Frost33/Control-ON-OFF-para-horno-con-temperatura-maxima-70-C-/README.md

# Control-ON-OFF-para-horno-con-temperatura-maxima-70-C-
En este repositorio se especifica el diseño de un controlador ON-OFF para una planta termica de primer Orden
