Frost33/Control-ON-OFF-para-horno-con-temperatura-maxima-70-C-/DiseñoDisparador.pdf

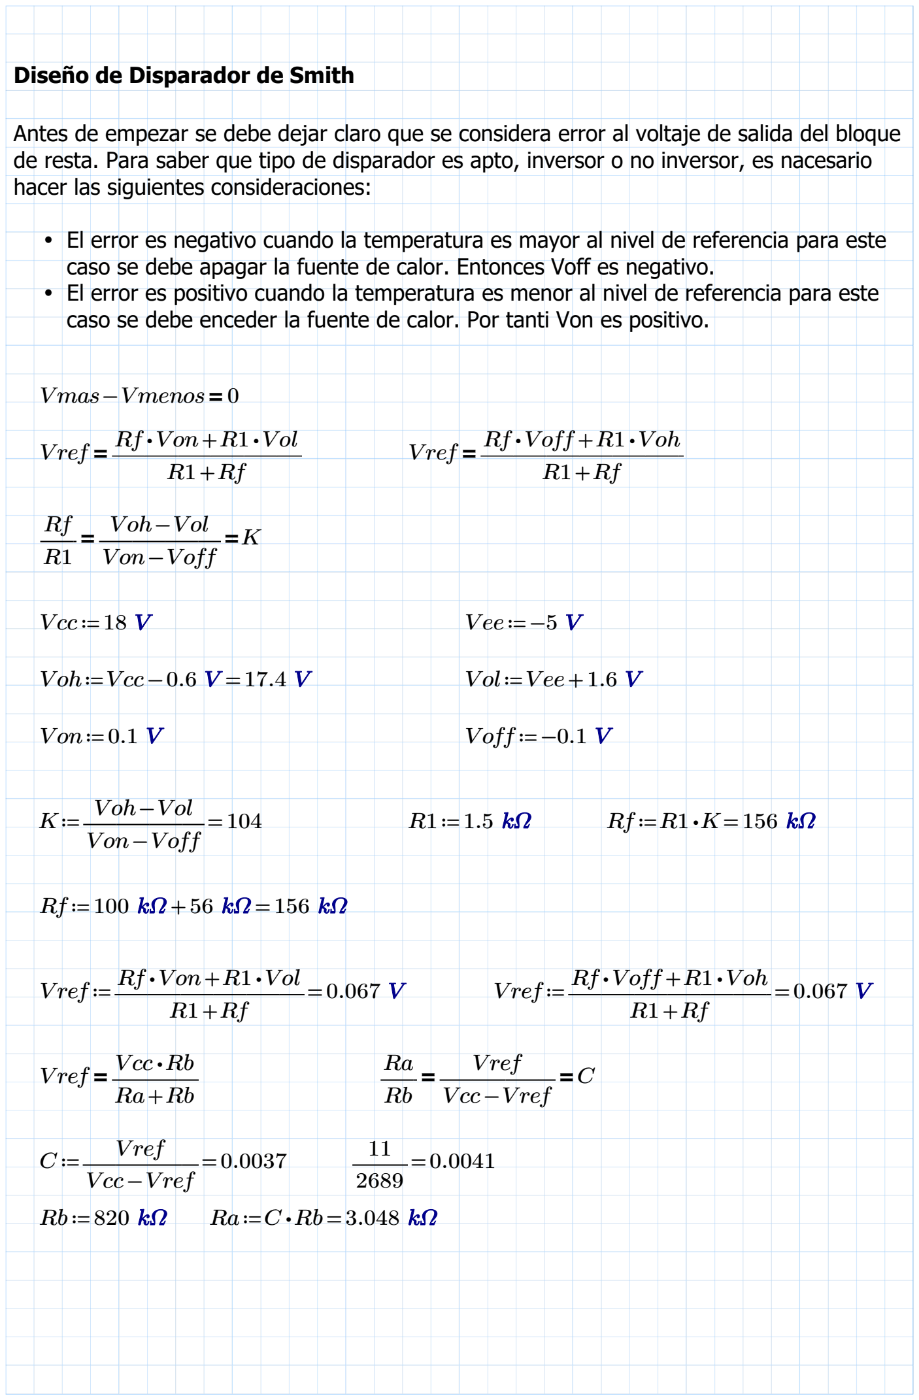
[picture p1: page 1]

Diseño de Disparador de Smith

Antes de empezar se debe dejar claro que se considera error al voltaje de salida del bloque de resta. Para saber que tipo de disparador es apto, inversor o no inversor, es nacesario hacer las siguientes consideraciones:

El error es negativo cuando la temperatura es mayor al nivel de referencia para este caso se debe apagar la fuente de calor. Entonces Voff es negativo.
El error es positivo cuando la temperatura es menor al nivel de referencia para este caso se debe enceder la fuente de calor. Por tanti Von es positivo.

Vmas−Vmenos＝0
Vref＝―Rf―⋅Von―+―R1―⋅Vol ― R1+Rf

Vref＝―Rf―⋅Voff ―+―R1―⋅Voh ―― R1+Rf

――＝ | ＝

Rf

R1 ―Voh―−―Vol― Von−Voff
K
Vcc≔18 V | Vee≔−5 V
Voh≔Vcc−0.6 V =17.4 V | Vol≔Vee+1.6 V
Von≔0.1 V | Voff≔−0.1 V

K≔――――=

Voh−Vol
Von−Voff
104 | R1≔1.5 kΩ | Rf≔R1 ⋅K=156 kΩ

Rf≔100 kΩ +56 kΩ =156 kΩ

Vref≔――――――=

Rf ⋅Von+R1 ⋅Vol
R1+Rf
0.067 V | Vref≔―――――――=
| | Rf ⋅Voff+R1 ⋅Voh R1+Rf 0.067 V
Vref＝―Vcc―⋅Rb― Ra+Rb | ――＝ | ＝
| Ra Rb ――Vref―― Vcc−Vref | C

C≔――――=

Vref
Vcc−Vref

0.0037 ――=

| 11
| 2689
| 0.0041
Rb≔820 kΩ | Ra≔C⋅Rb=3.048 kΩ

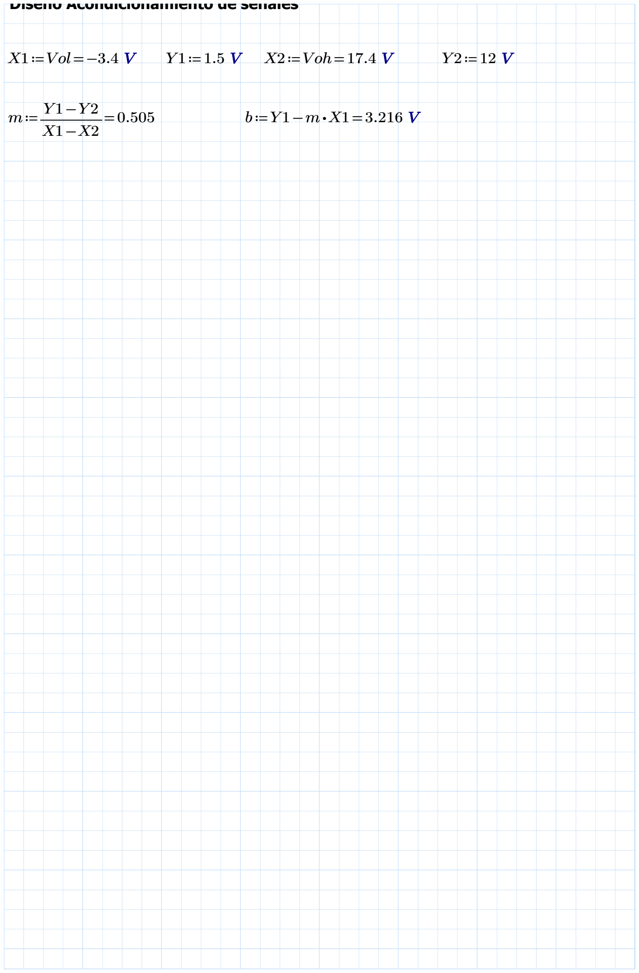
[picture p2: page 2]

Diseño Acondicionamiento de señales

X1≔Vol=−3.4 V | Y1≔1.5 V X2≔Voh=17.4 V | Y2≔12 V

m≔―――=

Y1−Y2
X1−X2

0.505 b≔Y1−m⋅X1=3.216 V
