Frost33/Control-ON-OFF-para-horno-con-temperatura-maxima-70-C-/Practica3-ControlON-OFF.pdf

# Practica No.3 Caracterización y Control ON/OFF de

un Sistema Térmico.

Nicolás David Pastran Zamora Ingeniería Elecrtrónica
Universidad Distrital Francisco José de Caldas
Bogotá, Colombia
ndpastranz@correo.udistrital.edu

David Sebastián Rodriguez Jímenez Ingeniería Elecrtrónica
Universidad Distrital Francisco José de Caldas
Bogotá, Colombia
dsrodriguezj@correo.udistrital.edu.co

Daniel E. A. Hernández Carreño Ingeniería Elecrtrónica
Universidad Distrital Francisco José de Caldas
Bogotá, Colombia
deahernandezc@correo.udistrital.edu.co

Abstract—The characterization of a thermal system is performed using the step response method and an On-Off temperature control is implemented considering the stages of census, power and conditioning of the error signal.

Resumen—Se realiza la caracterización de un sistema térmico usando el método de respuesta al escalón y se implementa un control de temperatura On-Off considerando las etapas de censado, potencia y acondicionamiento de la señal de error.

Palabras clave— Caracterización, Control, Error, Potencia, Señal, Temperatura.

I. INTRODUCCIÓN
En esta práctica de laboratorio se propone realizar el montaje, caracterización e implementación de un sistema térmico con un control de temperatura ON/OFF.
Para la construcción la planta térmica se precisa usar un bombillo de faro para motocicleta de 12 V y 20 W como fuente térmica, un censor de temperatura LM35 para el medir la temperatura interna de la planta térmica, envases de icopor de 24 oz como aislamiento y cuerpo de la planta térmica; usando dos envases de icopor, en el interior de los cuales se coloca el bobillo y el sensor de temperatura fijos en su lugar con macilla epoxi, dejando las conexiones eléctricas de cada uno accesibles desde el exterior de la planta.
El sistema control ON/OFF consiste de una etapa acondicionamiento de la señal de voltaje del LM35 y un comparador con el valor de referencia, empleando los amplificadores operacionales TL084CN y LM353.
Para controlar el encendido y apagado del bobillo se precisa de una etapa de potencia conformada por un seguidor de voltaje y un transistor MOSFET IRFP250N.
La caracterización de la planta térmica se realiza en lazo abierto con el funcionamiento de las etapas de potencia y de comparación, teniendo un valor de referencia fijo entre 0 y 12 V.

II. DESCRIPCIÓN DEL SISTEMA
Para este laboratorio se implementa un sistema de lazo cerrado como el mostrado en la Fig. 1.
Donde la señal de entrada es un voltaje de referencia el cual representa la temperatura deseada y la salida es la temperatura que tiene la planta.

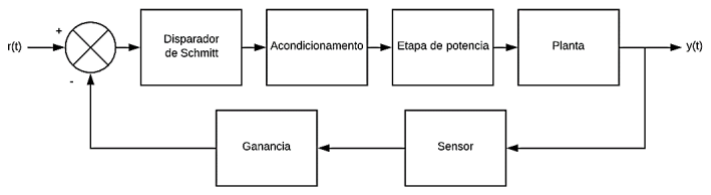
[picture p3: figure]

Fig. 1. Diagrama de bloques del sisetame de lazo cerrado.

Para el diseño del primer bloque (el disparador de Schmitt), se utilizan las ecuaciones de diseño de un disparador de Schmitt no inversor como el de la Fig. 2, las cuales son:

Rf
R1

=

VOH − VOL

VON −VOFF

VREF =

VON RF + VOL R1
R1 + RF | , | VREF =

VOFF RF + VOH R1
R1 + RF

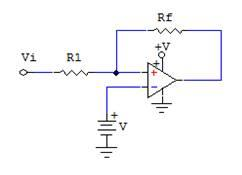
[picture p4: figure]

Fig. 2. Topologia de disparador de Schmitt no inversor.

Para este diseño se decide usar una fuente Vcc

+ de 18V para
sobredimensionar perdidas por la etapa de potencia y Vcc

− de
-5V para sobredimensionar la mínima entrada negativa.
Con anterioridad se caracterizo VOH y VOL del lm que se utilizara para tener más precisión, los resultados fueron:

VOH = Vcc

+ − 0.6 = 17.4V, VOL = Vcc

− + 1.6 = −3.4V

Para este diseño se sabe que VON = 0.1 y VOFF = −0.1 , con estos datos se procede a hallar los valores de las resistencias:

RF
R1

=

17.4 + 3.4
0.1 + 0.1

= 104, RF = 104 R1

VREF =

0.1 104 + (−3.4) 1
1 + 104 =

1
15

VREF =

(−0.1)104 + 17.4 1
1 + 104 =

1
15

El voltaje VREF se hace haciendo un divisor resistivo con Vcc

+ ya que la impedancia de entrada del amplificador operacional es muy alta, por lo la relación resistiva es la siguiente:
1
15 =

18V Ra
Ra + Rb ,

Rb
Ra = 15 × 18 − 1 = 269

Rb = 269 Ra

Dadas estas condiciones de diseño se buscan las resistencias adecuadas que cumplan esas características, para este caso se encontró que:

Si R1 = 1.5KΩ entonces RF = 156KΩ = 100KΩ + 56KΩ

Si Ra = 820KΩ entonces Rb = 3.048KΩ ≈ 3KΩ

El bloque de acondicionamiento es necesario dado que la salida del disparador será VOH = 17.4 y VOL = −3.4 pero la entrada de la etapa de potencia idealmente debería ir máximo hasta 12V ya que es el valor nominal del bombillo utilizado y
mínimo 1.5V ya que este tendrá como Vcc | − = 0V por lo quela
entrada mínima debe ser aproximadamente VIL = Vcc

− +1.5 =
1.5V ademas para este voltaje el bombillo aún no ha encendido así que no es necesario que el voltaje de entrada del seguidor sea 0, asimismo otra ventaja es que el transistor utilizado para la etapa de potencia tiene que soportar un voltaje equivalente a la siguiente ecuación:

Vtransistor = Vcc

+ −Vbombillo

Por lo tanto, si el voltaje mínimo del bombillo es mayor a cero, el voltaje que debe soportar el transistor no será siempre menor al que entrega la fuente de polarización haciendo menos probable que este se queme.
Para el diseño de esta etapa se busca que cuando el voltaje de entrada sea -3.4V el voltaje de salida sea 1.5V y cuando el voltaje de entrada sea 17.4V el voltaje de salida sea 12V, los valores intermedios deben actuar de manera lineal, por lo que se halla la ecuación que describe la función lineal dados dos puntos:

m =

y2 − y1
x2 − x1

=

12 −1.5 17.4 + 3.4 | =
| 105
| 208

Hallada la pendiente se procede a hallar el punto de corte con el eje y (llamado b).

12 =

105
208

× 17.4 +b

b = 12 −

105

208 × 17.4 = | 669
| 208

De este modo la función deseada es:

y =

105
208 Vi +

669
208 , y =

105
208 Vi +

223
1248 18V

Se usa un multientradas para generar esa función de transferencia, por lo que se utilizan las ecuaciones del diseño de multientradas:
A

+ = A

− +1, | A + =
| 105 208 + | 223 1248 =
| | 853
| | 1248

Como A

+ < 1 entonces A

− = 0 y falta agregar una
ganancia positiva más para completar 1.

853
1248 +Aa
+ = 1, | Aa
| + = 1 − | 853 1248 =
| | 395
| | 1248

Por lo que se evidencia que no es necesario hacer un multi entradas, sino que se puede hacer un acondicionamiento resistivo con tres resistencias y luego el seguidor de la etapa de potencia, donde Ra ira conectada a la salida del disparador, Rb a Vcc

+y
Rc a tierra.
Para facilitar su cálculo se sigue tratando como un multi entradas con la siguiente ecuación:

y =

105
208 Vi +
| 223 1248 18V + | 395 1248 0V

De donde la relación de resistencias será:

Rf Ra =

105

208 | Rf Rb =
| 223
| 1248 | Rf Rc =
| | 395
| | 1248

Con estos datos se pueden hallar las relaciones entre resistencias sin tener en cuenta Rf, dividiendo entre sí, de manera que:

Ra
Rc =

395
1248 ÷
105 208 = | 79 126 , Rb Rc = | 395
| | 1248 ÷
| | 223 1248 =

395
223

Por lo que tenemos dos grados de libertad, de este modo buscamos valores adecuados para aproximarnos lo más posible a estas relaciones, para nuestro caso se escogieron:

Ra = 15KΩ | Rb = 45KΩ | Rc = 22KΩ

Para la etapa de potencia se diseña un seguidor de voltaje de potencias con un amplificador operacional y un transistor MOSFET de potencia, como el de la Fig. 3. De forma que el voltaje Vref a la entrada del amplificador operacional excitará la compuerta del MOSFET y el voltaje sobre el bobillo será próximo al voltaje Vref

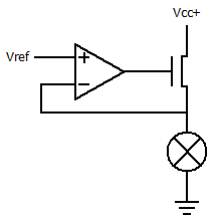
[picture p5: figure]

Fig. 3. Etapa de potencia. Seguidor de voltaje.

Para proporcionar la corriente necesaria para encender el bombillo en el rango de 0 V a 12 V, se sobre dimensiona el diseño y se escoge trabajar con un el transistor de potencia IRFP250N, que soporta una corriente iD de 30 A y una disipación de potencia de 214 W.
Dada la realimentación negativa del operacional V

+ = V

−
el voltaje sobre el bobillo (el cual se tratará como una resistencia R), será gmvgsR, por lo tanto

V

+ = V

− = gmvgsR, vgs =

V

−
gmR

v0 = vgs + V

−, v0 = V

− (1 +

1
gmR

)

Según [3], el valor de gm para el IRFP250N es de 17 S y el valor de resistencia del bombillo a 12 V es de 6.1 Ω. El límite de operación se encontrará cuando v0
se acerque al valor de la
fuente de polarización, es decir, cuando Vref sea 12 V

v0,max = 12 (1+

1
17 ∗ 6.1

) = 12.12 V

Para el caso del TL084CN con polarización +Vcc = 18 V y −Vcc = 0 V, el valor de voltaje v0,max y v0,min que se podrá tener a la salida antes que se sature el amplificador operacional es de 17 V y 1 V respectivamente [4]. Por lo tanto, el seguidor de voltaje de potencia se comportará de manera lineal en el rango de 1.5 V a 12 V.
Para la etapa de censado se emplea un sensor de temperatura de LM35, para este se tiene un rango de temperatura operación de temperatura de -55 °C a 150°C, con una precisión de 1 °C a temperatura ambiente y de 1.5°C a la temperatura máxima. El LM35 puede ser polarizado como máximo con una fuente de 30 V y requiere un voltaje mínimo de polarización de 3.5 V para realizar medidas a 75 °C. [2]
Para polarizar el amplificador operacional se usa un rectificador de voltaje a 5.1 V, como el de la Fig. 4, para asegurar que el sensor realice mediaciones estables y certeras ene l rango de 25°C a 75°C. También se toma la sugerencia del fabricante para usar el sensor con una sola fuente junto con un amortiguador RC, para disminuir el ruido eléctrico de alta frecuencia en la salida del sensor. [2]

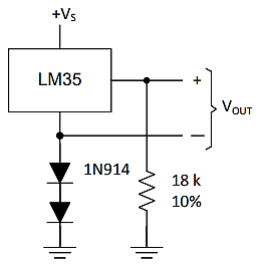
[picture p6: figure]

Fig. 4. Sensor LM35 polarizado con una fuente. [2]

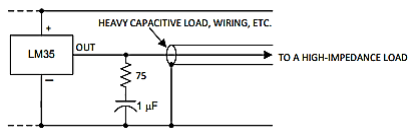
[picture p7: figure]

Fig. 5. Sensor LM35 con amortiguador RC. [2]

La respuesta del sensor al aire quieto tarda 4 minutos en llegar al 100% del valor final, este aspecto que se ve incluido en la caracterización de la planta más adelante. [2]
Posterior a la etapa de censado, por datos del diseño se debe adecuar la salida del sensor para que el voltaje que entre al restador sea de 100 mV
C°

dado que el sensor utilizado tiene como salida 10 mV
C°

es evidente que es suficiente con amplificar la salida 10 veces, para esto se utilizara la topología del amplificador no inversor como el mostrado en la Fig. 3 cuya ecuación que describe su comportamiento es:

Vo = 1+

Rf
R1

= 10

Rf
R1

= 9

Para cumplir esta condición se escogen los siguientes valores resistivos:
Rf = 9KΩ = 18KΩ//18KΩ
R1 = 1KΩ

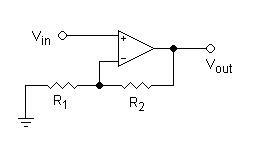
[picture p8: figure]

Fig. 6. Topologia de amplificador no inversor.

Por último, se procede al diseño del restador como el visto en la Fig. 4.
Ajustando la ecuación para que cumpla que A

+ = A

− + 1 se
tiene que:

y = Va − Vb + 1

Donde Va es la entrada del sistema y Vb es la salida del sensor amplificada. Con estos datos se procede a hallar la relación de resistencias adecuadas para satisfacer la ecuación:

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
Por lo que para satisfacer la ecuación todas las resistencias deben ser iguales.

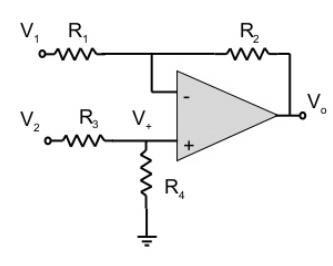
[picture p9: figure]

Fig. 7. Topologia de multientradas (restador).

III. IDENTIFICACIÓN DEL SISTEMA
Para identificar el sistema descrito en la Fig. 1 de forma analítica, se planteará el modelamiento del sistema dinámico por medio de variables de estado, una vez obtenidas estas encontrar la ecuación característica del sistema, donde la entrada será el voltaje de la resistencia y la salida la temperatura del recipiente.

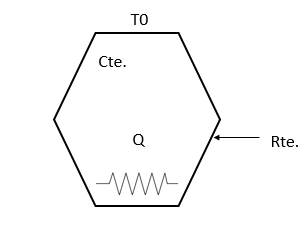
[picture p10: figure]

Fig. 8. Figura Representativa para el sistema.

Modelamiento Teórico

Para modelar el sistema se deben identificar los elementos que componen al mismo, estos son la resistencia al flujo de calor en el resipiente, caracteristica por las dimenciones del resipiente y el material del mismo; el otro elemento del sistema es la capacitancia inherente de los cuerpos al almacenar calor en forma de energia interna, esta propiedad existe debido al fluido que almacenado en el resipiente y de su volumen. Antes de empezar el modelamiento se realizara el calculo de estos elementos para el sistema particular. Para el elemento disipador de energia:

Rℎ =

A
l ∗ ρ
Donde:

Rℎ, Es la Resistencia terminal
A, Es el Área del recipiente la base, la tapa y las laterales l , Es el espesor del recipiente
ρ, Es la conductividad del material en este caso poliestireno expandido

Rl =

2 ∗ π ∗ 6cm ∗ 24cm
2m ∗ m ∗ 0.041 W
K ∗ m

= 1103.38

K
W

Rb =

π ∗ (6cm)

2
2m ∗ m ∗ 0.041 W
K ∗ m

= 137.92

K
W

Rt =

π ∗ (6cm)

2
2m ∗ m ∗ 0.041 W
K ∗ m

= 137.92

K
W

Rℎ = Rs||Rb||Rt = 64.90

K
W

Para el elemento que almacena energia potencial:

Cℎ = p ∗ V ∗ Cp
Donde:

Cℎ, Es la Capacitancia Térmica
V, Es el Volumen del recipiente
p , Es la densidad del fluido en este caso aire
Cp, Es el calor especifico del fluido en este caso aire

Cℎ = π ∗ (6cm)

2
∗ 24cm ∗ 1.225

kg
m³

∗ 1012

J
kg ∗ K

Cℎ = 3.36

J
K
Ecuaciones características del sistema

Qint = QRH + QCH

Qint =

T
Rℎ

+ Cℎ ∗

dT
dt
Qint = T (

1
Rℎ

+ Cℎ ∗ S)

T =

Qint ∗ Rℎ
1+ Cℎ ∗ Rℎ ∗ S

Como Qint es la potencia disipada por el bombillo se puede expresar como

Qint =

V

2
R
Donde:

V es la tensión de salida del sistema de control R es la resistencia eléctrica del Bombillo R = 7Ω

T = 0.042 ∗

V

2
4.58 ∗ 10⁻ ³ +S

Modelamiento Experimental

Para realizar el modelamiento de forma experimental, se realizó un análisis al comportamiento del mismo ante una entrada escalón unitario. Una vez el sistema tuviera una temperatura estable se aumenta 1 voltio la tensión del bombillo, de tal manera que este aumentara la potencia entregada al sistema en forma de calor y el sistema generara una respuesta. Se empezaron a ajustar los valores de tensión del bombillo desde 4 voltios en adelante ya que a un voltaje menor que este el bombillo no encendía. A continuación, se muestra los resultados obtenidos en el osciloscopio usando la etapa de censado (LM35) y el amplificador por 10.

Cabe resaltar que la respuesta del sistema es muy variable debido a condiciones ambientales y errores en la medida, como la inestabilidad de la etapa de censado, el offset característico de los amplificadores operacionales, el ruido blanco que interfiere la medida o inestabilidad en la fuente que le entrega energía al sistema para este caso la etapa de potencia descrita anteriormente. Por estas razones algunas medidas fueron tomadas hasta que las mediciones fueran estables y congruentes, en la mayor parte de los casos antes de llegar al estado estable estacionario.

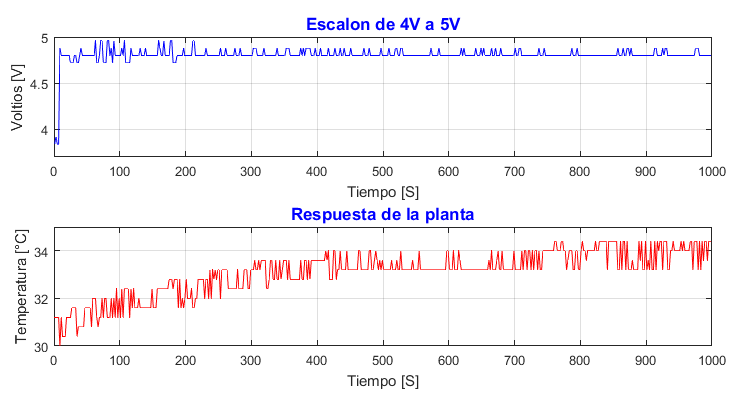
[picture p11: figure]

Fig. 9. Respuesta del sistema para Voltaje de entrada de 4 V a 5 V

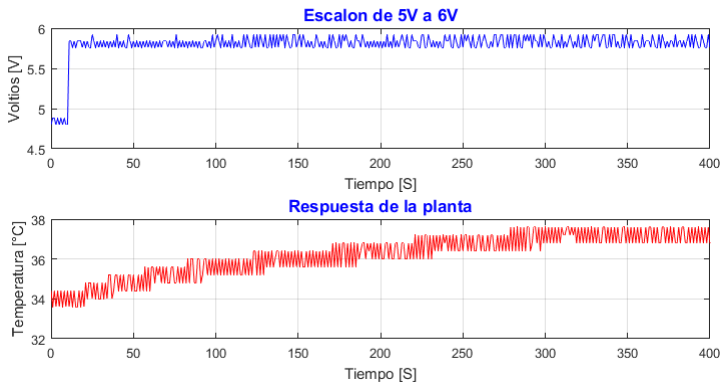
[picture p12: figure]

Fig. 10. Respuesta del sistema para Voltaje de entrada de 5 V a 6 V

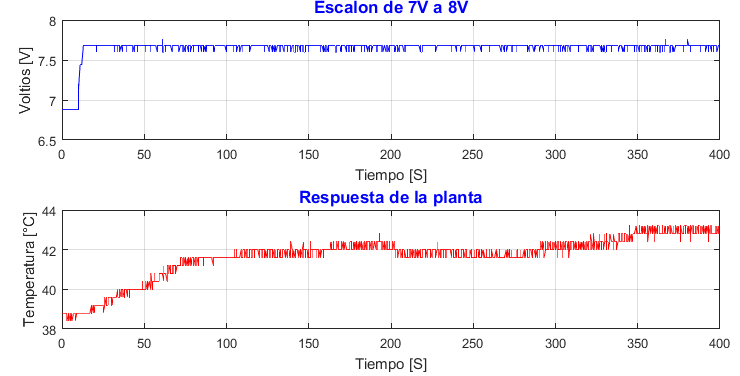
[picture p13: figure]

Fig. 11. Respuesta del sistema para Voltaje de entrada de 7 V a 8 V

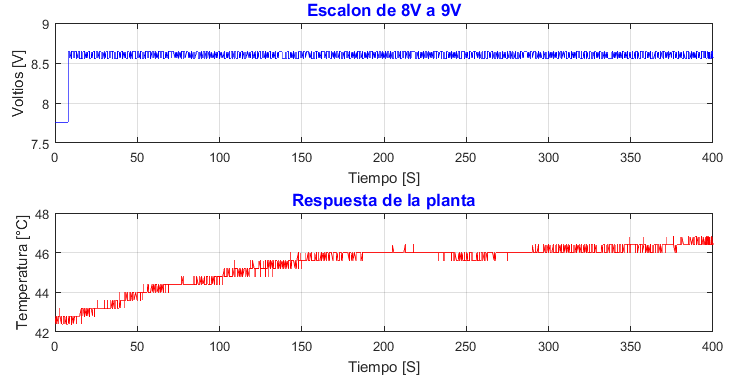
[picture p14: figure]

Fig. 12. Respuesta del sistema para Voltaje de entrada de 8 V a 9 V

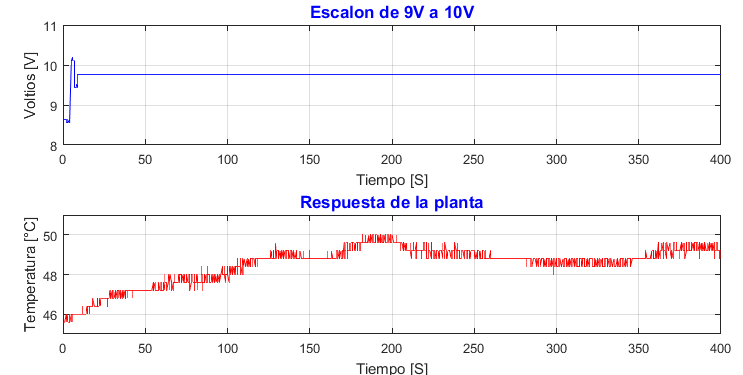
[picture p15: figure]

Fig. 13. Respuesta del sistema para Voltaje de entrada de 9 V a 10 V

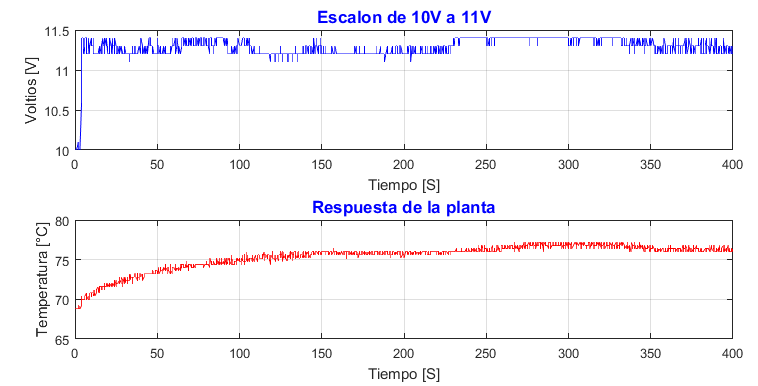
[picture p16: figure]

Fig. 14. Respuesta del sistema para Voltaje de entrada de 10 V a 11 V

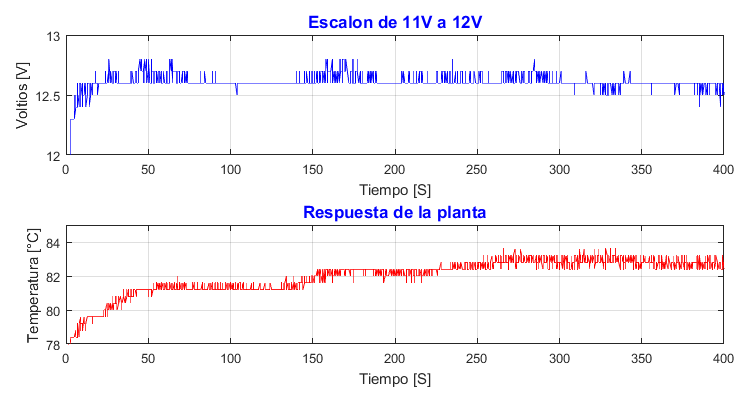
[picture p17: figure]

Fig. 15. Respuesta del sistema para Voltaje de entrada de 11 V a 12 V

Como dato adicional se tomo la medida de un escalon mayor a un voltio, para obtener un mayor rango de valores mas amplio lo que permite una mejor visualizacion, en la siguiente figura se puede ver sus resultados:

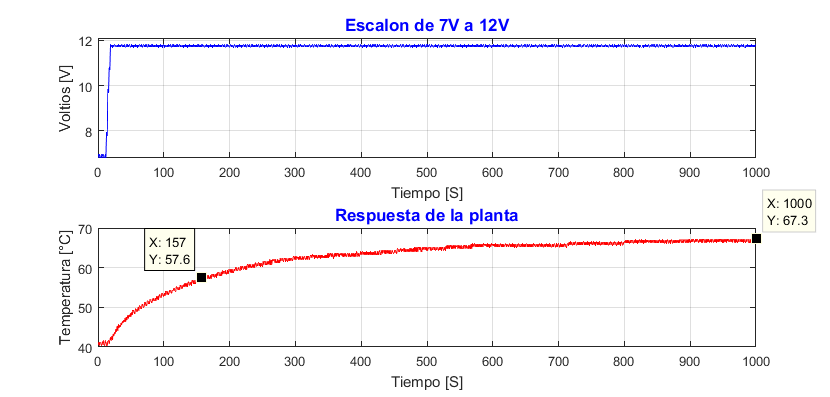
[picture p18: figure]

Fig. 16. Respuesta del sistema para Voltaje de entrada de 7 V a 12 V

Para comparar la respuesta del sistema para cada entrada se hace una gráfica, restando el valor inicial de cada respuesta. Por efectos visuales se realiza la gráfica con solo 4 escalones:

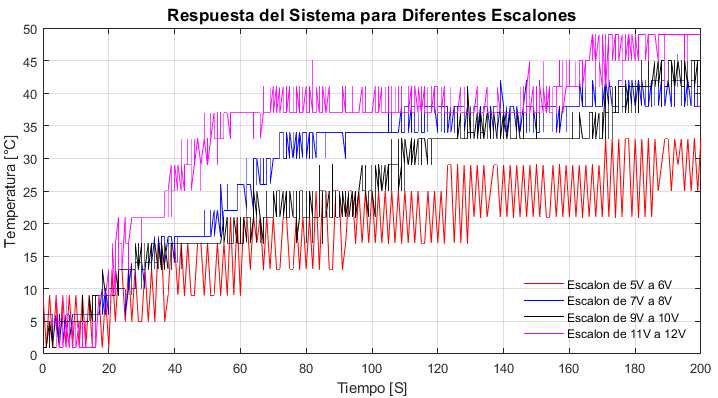
[picture p19: figure]

Fig. 17. Respuesta del sistema para Diferentes Escalones

A partir de las gráficas obtenidas con anterioridad y sabiendo que el sistema es de primer orden, gracias al análisis teórico. Se puede estimar la ecuación característica del sistema. Para este análisis se usará la gráfica de la figura 2 y de la figura 9, el estado estable estacionario llega después de haber pasado cerca de 1000 segundos, a partir de este valor podemos calcular el τ característico del sistema. El sistema llega al estado estable después de 5τ aproximadamente de modo que:

5 ∗ τ = 1000, τ = 200

Otra opción para calcular el τ característico del sistema usando la figura 9, aplicando el siguiente criterio. En el 63% del valor de estado estable estacionario, el tiempo transcurrido es igual a τ, de modo que podemos hacer el calculo de la siguiente forma:

V67% = 0.63(Vtest − Vt0) + Vt0

V67% = 0.63(67.3°C −40°C) +40°C = 57.46

τ = 157 s

Haciendo un análisis general de todas las gráficas podemos observar que cierto tiempo después de haber el escalón, el sistema presentaba oscilaciones debido a las condiciones ambientales en las que se encontraba el mismo, por tales razones se hace complicado observar el estado estable estacionario.

Para obtener la función equivalente del sistema partimos del hecho que existe que todos los sistemas térmicos tienen una temperatura inicial, la cual traducimos a voltaje de modo la función de transferencia de la siguiente forma:

T(V) =

k T ∗ s + 1 | Vin(V)+ Ta(V)

De la etapa de censado junto con el acondicionamiento respectivo y asumiendo la temperatura ambiente de 25 °C, tenemos que:

T(V) =

k
T ∗ s + 1

Vin(V)+ 0.25V

Aplicando el teorema del valor final tenemos que:

T(V) = lims→0

k
T ∗ s + 1

Vin(V) + 2.5V = k ∗ Vin(V)+ 0.25V

A partir del supuesto anterior pasamos a calcular k:

TABLE I. | REGRESION LINEAL PARA ENCONTRAR VALOR DE K
Vin | Vout | Vin*Vout | Vin
5 | 3.4 | 17 | 25
5.8 | 3.8 | 22.04 | 33.64
7.6 | 4.27 | 32.452 | 57.76
8.6 | 4.64 | 39.904 | 73.96
9.8 | 5.5 | 53.9 | 96.04
11.4 | 7.6 | 86.64 | 129.96 | Total
a. Tabla 1 Regresión lineal para hallar valor de K
La grafica correspondiente junto con la línea de tendencia:

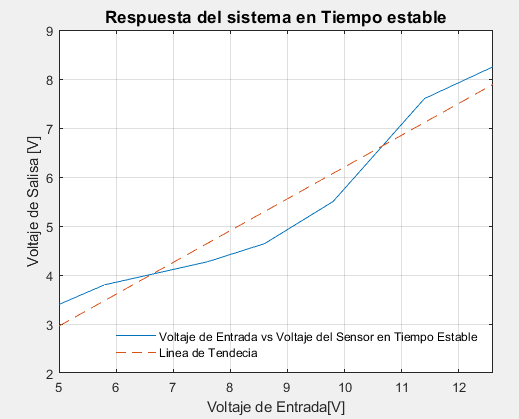
[picture p20: figure]

Fig. 18. Respuesta del sistema aplicando el teorema del valor final

Se realiza mínimos cuadrados perfectos obtenemos el valor de la pendiente equivalente a k.
k = 0.6489
Se obtiene la función de transferencia equivalente:
T(V) =

0.6489
T ∗ s + 1

Vin(V)+ 0.25V

IV. RESULTADOOS
Una vez implementado el control ON-OFF, se observó la respuesta del sistema para diferentes voltajes de referencia, obteniendo los siguientes resultados:

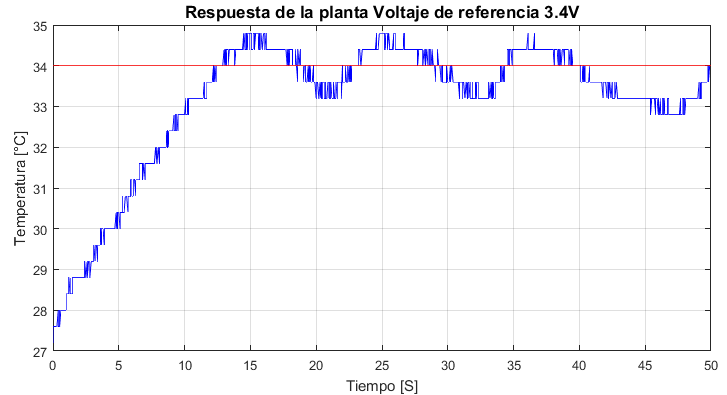
[picture p21: figure]

Fig. 19. Respuesta de la planta para un voltaje de referencia 3.4V equivalente a 34°C

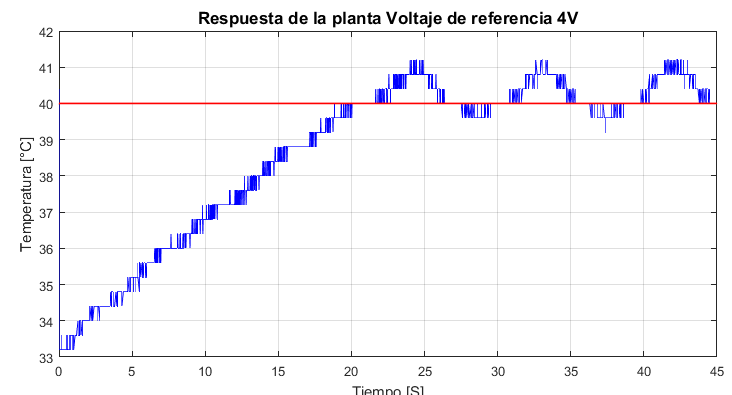
[picture p22: figure]

Fig. 20. Respuesta de la planta para un voltaje de referencia 4V equivalente a 40°C

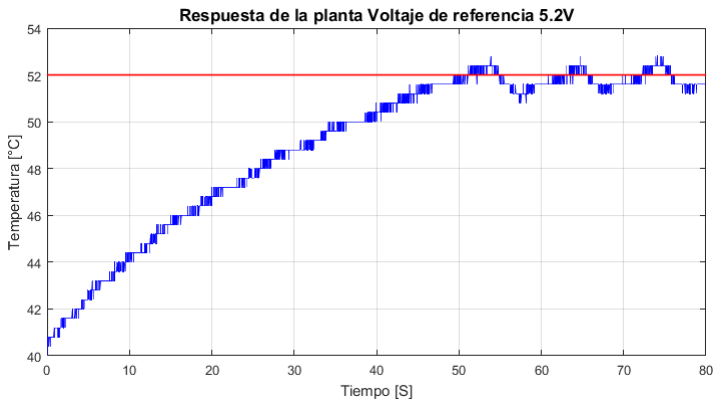
[picture p23: figure]

Fig. 21. Respuesta de la planta para un voltaje de referencia 5.2V equivalente a 52°C

V. CONCLUSIONES
Para caracterizar un sistema no solo basta con conocer la respuesta al escalón, ya no se tiene certeza del orden del mismo, puesto que un sistema de segundo orden con ξ > 1 tiene una respuesta similar a un sistema de primer orden, entonces se hace necesario hacer el modelamiento dinámico del mismo por medio de variables de estado, hasta hallar la ecuación característica del mismo.
Durante la implementación se destaca la necesidad de usar el circuito retardador RC para la salida de voltaje del sensor LM35, como se observa en las figuras 9 y 10 dada la gran variación que se presenta en la medición se requiere disminuir estas las fluctuaciones de voltaje para garantizar el buen comportamiento de los sistemas de control que se deseen implementar en la planta; como se observa en la figura 16, la implementación del circuito retardador RC permite obtener un señal más estable útil para la comparación con un voltaje de referencia.
A la hora de implementar un control ON-OFF es más optimo implementar un arreglo de transistores push-pull que una etapa seguidora de voltaje, ya que el consumo de potencia es menor debido a que los transistores que están únicamente en corte o en saturación en donde la potencia disipada por los mismos es mínima. Por el contrario, al implementar un seguidor de potencia, se trabaja en la zona activa de los transistores, en donde tenemos el mayor consumo de potencia de estos.

El sistema térmico presenta diferentes características dinámicas en función de la temperatura interna de la planta térmica, como se puede observar en la figura 18 a 20, a medida que aumenta la temperatura interna de la planta térmica, se observa un comportamiento de saturación térmica por lo cual la temperatura aumenta con menor velocidad.
Como se puede apreciar en la figura 18 al contrastarla con la Figura 19 el tiempo que tarda en enfriase la planta es mayor que el tiempo que tarda en calentarse para temperaturas de referencia más bajos y a su vez el tiempo que tarda en calentarse es menor.
En las Figuras 17,18,19 se observa como la pendiente de subida de la temperatura es menor para mayores valores de voltaje de referencia y del mismo modo la pendiente negativa es menor entre menor sea el valor de voltaje de referencia.

REFERENCIAS

[1] Ogata, K. (2010). Ingeniería de control moderna. Madrid: Pearson Educación. Quinta edición.
[2] "LM35 Precision Centigrade Temperature Sensors", Texas Instruments, 2017. [Online]. Available: http://www.ti.com/lit/ds/symlink/lm35.pdf.
[3] "IRFP250N N-Channel Power MOSFET", Fairchid semiconductor, 2002.
[Online]. | Available:
http://pdf.datasheetcatalog.com/datasheet/fairchild/IRFP250N.pdf.
[4] "TL08xx JFET-Input Operational Amplifiers", Texas Instruments, 2015. [Online]. Available: http://www.ti.com/lit/ds/symlink/tl082.pdf.
[5] Apuntes de clase de control I, dictado por IE. Diana Marcela Ovalle Martínez, PhD en la Universidad Distrital Francisco José de Caldas.

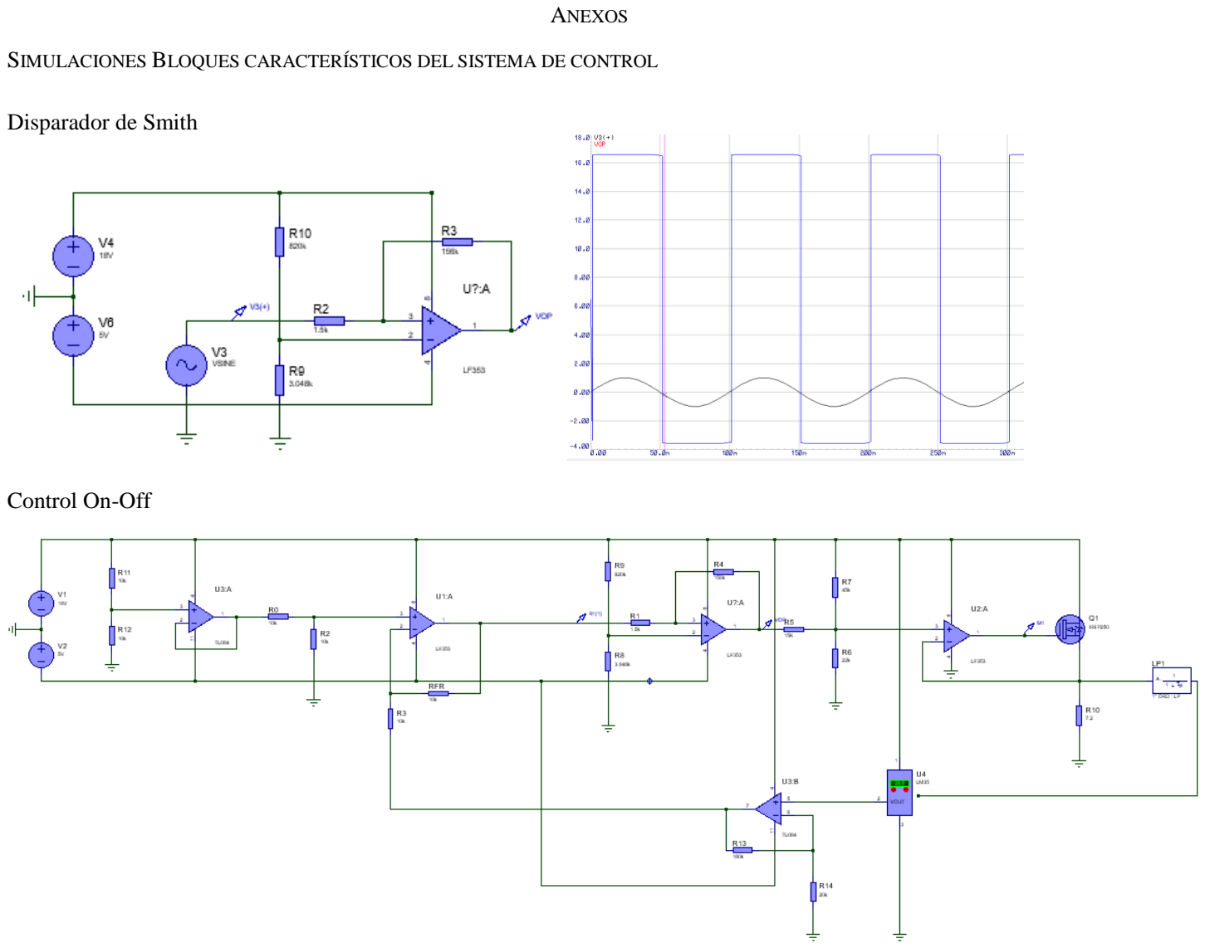
[picture p24: page 9]

ANEXOS

SIMULACIONES BLOQUES CARACTERÍSTICOS DEL SISTEMA DE CONTROL

Disparador de Smith

Control On-Off
