Frost33/Control-ON-OFF-para-horno-con-temperatura-maxima-70-C-/(list of files, drawings)

Other design files:
SimulacionesProteus/Disparador.pdsprj
SimulacionesProteus/DisparadorEtapadePotencia.pdsprj
SimulacionesProteus/Restador.pdsprj
SimulacionesProteus/SistemaON-OFF.pdsprj
