Frost33/Control-ON-OFF-para-horno-con-temperatura-maxima-70-C-/Caracterizacion/DatosExperimentales/EscalonV10a11.csv

X | CH1 | CH2
Second | Volt | Volt
-5.12e+02 | 6.88e-01 | 1.00e+01
-5.12e+02 | 6.88e-01 | 1.00e+01
-5.12e+02 | 6.88e-01 | 1.00e+01
-5.11e+02 | 6.88e-01 | 1.00e+01
-5.11e+02 | 6.88e-01 | 1.00e+01
-5.11e+02 | 6.88e-01 | 1.00e+01
-5.11e+02 | 6.88e-01 | 1.00e+01
-5.11e+02 | 6.88e-01 | 1.00e+01
-5.10e+02 | 6.88e-01 | 1.01e+01
-5.10e+02 | 6.88e-01 | 1.00e+01
-5.10e+02 | 6.88e-01 | 1.00e+01
-5.10e+02 | 6.92e-01 | 1.01e+01
-5.10e+02 | 6.88e-01 | 1.00e+01
-5.09e+02 | 6.88e-01 | 1.00e+01
-5.09e+02 | 6.92e-01 | 1.00e+01
-5.09e+02 | 6.88e-01 | 1.00e+01
-5.09e+02 | 6.88e-01 | 1.00e+01
-5.09e+02 | 6.88e-01 | 1.00e+01
-5.08e+02 | 6.92e-01 | 1.06e+01
-5.08e+02 | 6.96e-01 | 1.09e+01
-5.08e+02 | 7.04e-01 | 1.14e+01
-5.08e+02 | 7.00e-01 | 1.14e+01
-5.08e+02 | 7.00e-01 | 1.14e+01
-5.07e+02 | 7.00e-01 | 1.14e+01
-5.07e+02 | 7.00e-01 | 1.12e+01
-5.07e+02 | 7.00e-01 | 1.13e+01
-5.07e+02 | 7.00e-01 | 1.13e+01
-5.07e+02 | 7.00e-01 | 1.12e+01
-5.06e+02 | 7.00e-01 | 1.13e+01
-5.06e+02 | 7.00e-01 | 1.12e+01
-5.06e+02 | 7.00e-01 | 1.12e+01
-5.06e+02 | 7.00e-01 | 1.13e+01
-5.06e+02 | 7.04e-01 | 1.14e+01
-5.05e+02 | 7.08e-01 | 1.14e+01
-5.05e+02 | 7.00e-01 | 1.14e+01
-5.05e+02 | 7.04e-01 | 1.14e+01
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
