Frost33/Control-ON-OFF-para-horno-con-temperatura-maxima-70-C-/Caracterizacion/DatosExperimentales/EscalonV11a12.csv

X | CH1 | CH2
Second | Volt | Volt
-5.12e+02 | 7.80e-01 | 1.14e+01
-5.12e+02 | 7.80e-01 | 1.14e+01
-5.12e+02 | 7.80e-01 | 1.14e+01
-5.11e+02 | 7.80e-01 | 1.14e+01
-5.11e+02 | 7.80e-01 | 1.14e+01
-5.11e+02 | 7.80e-01 | 1.14e+01
-5.11e+02 | 7.80e-01 | 1.14e+01
-5.11e+02 | 7.80e-01 | 1.14e+01
-5.10e+02 | 7.80e-01 | 1.14e+01
-5.10e+02 | 7.76e-01 | 1.14e+01
-5.10e+02 | 7.84e-01 | 1.15e+01
-5.10e+02 | 7.76e-01 | 1.14e+01
-5.10e+02 | 7.80e-01 | 1.15e+01
-5.09e+02 | 7.80e-01 | 1.14e+01
-5.09e+02 | 7.80e-01 | 1.14e+01
-5.09e+02 | 7.80e-01 | 1.14e+01
-5.09e+02 | 7.76e-01 | 1.14e+01
-5.09e+02 | 7.76e-01 | 1.15e+01
-5.08e+02 | 7.76e-01 | 1.14e+01
-5.08e+02 | 7.76e-01 | 1.14e+01
-5.08e+02 | 7.80e-01 | 1.14e+01
-5.08e+02 | 7.84e-01 | 1.14e+01
-5.08e+02 | 7.76e-01 | 1.14e+01
-5.07e+02 | 7.80e-01 | 1.14e+01
-5.07e+02 | 7.84e-01 | 1.14e+01
-5.07e+02 | 7.84e-01 | 1.14e+01
-5.07e+02 | 7.76e-01 | 1.14e+01
-5.07e+02 | 7.80e-01 | 1.14e+01
-5.06e+02 | 7.76e-01 | 1.14e+01
-5.06e+02 | 7.76e-01 | 1.14e+01
-5.06e+02 | 7.76e-01 | 1.14e+01
-5.06e+02 | 7.80e-01 | 1.14e+01
-5.06e+02 | 7.80e-01 | 1.14e+01
-5.05e+02 | 7.80e-01 | 1.14e+01
-5.05e+02 | 7.76e-01 | 1.14e+01
-5.05e+02 | 7.80e-01 | 1.14e+01
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
