Frost33/Control-ON-OFF-para-horno-con-temperatura-maxima-70-C-/Caracterizacion/DatosExperimentales/EscalonV5a6.csv

X | CH1 | CH2 | Start | Increment
Sequence | Volt | Volt | -3.000000e+02 | 5.000000e-01
0 | 3.44e+00 | 4.80e+00
1 | 3.36e+00 | 4.88e+00
2 | 3.44e+00 | 4.88e+00
3 | 3.36e+00 | 4.80e+00
4 | 3.44e+00 | 4.88e+00
5 | 3.36e+00 | 4.80e+00
6 | 3.44e+00 | 4.88e+00
7 | 3.36e+00 | 4.80e+00
8 | 3.44e+00 | 4.88e+00
9 | 3.36e+00 | 4.80e+00
10 | 3.44e+00 | 4.80e+00
11 | 3.36e+00 | 5.84e+00
12 | 3.44e+00 | 5.84e+00
13 | 3.36e+00 | 5.76e+00
14 | 3.44e+00 | 5.84e+00
15 | 3.36e+00 | 5.76e+00
16 | 3.36e+00 | 5.84e+00
17 | 3.44e+00 | 5.84e+00
18 | 3.36e+00 | 5.84e+00
19 | 3.44e+00 | 5.76e+00
20 | 3.36e+00 | 5.84e+00
21 | 3.48e+00 | 5.76e+00
22 | 3.40e+00 | 5.84e+00
23 | 3.48e+00 | 5.76e+00
24 | 3.48e+00 | 5.76e+00
25 | 3.40e+00 | 5.92e+00
26 | 3.48e+00 | 5.84e+00
27 | 3.40e+00 | 5.76e+00
28 | 3.48e+00 | 5.84e+00
29 | 3.40e+00 | 5.76e+00
30 | 3.40e+00 | 5.84e+00
31 | 3.48e+00 | 5.76e+00
32 | 3.40e+00 | 5.84e+00
33 | 3.48e+00 | 5.76e+00
34 | 3.40e+00 | 5.84e+00
35 | 3.52e+00 | 5.76e+00
36 | 3.52e+00 | 5.84e+00
37 | 3.40e+00 | 5.76e+00
38 | 3.44e+00 | 5.84e+00
39 | 3.52e+00 | 5.76e+00
40 | 3.52e+00 | 5.92e+00
41 | 3.44e+00 | 5.76e+00
42 | 3.52e+00 | 5.84e+00
43 | 3.44e+00 | 5.76e+00
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
