Frost33/Control-ON-OFF-para-horno-con-temperatura-maxima-70-C-/Caracterizacion/DatosExperimentales/EscalonV7a8.csv

X | CH1 | CH2
Second | Volt | Volt
-5.12e+02 | 3.88e-01 | 6.88e+00
-5.12e+02 | 3.88e-01 | 6.88e+00
-5.12e+02 | 3.88e-01 | 6.88e+00
-5.11e+02 | 3.88e-01 | 6.88e+00
-5.11e+02 | 3.88e-01 | 6.88e+00
-5.11e+02 | 3.88e-01 | 6.88e+00
-5.11e+02 | 3.88e-01 | 6.88e+00
-5.11e+02 | 3.88e-01 | 6.88e+00
-5.10e+02 | 3.88e-01 | 6.88e+00
-5.10e+02 | 3.88e-01 | 6.88e+00
-5.10e+02 | 3.88e-01 | 6.88e+00
-5.10e+02 | 3.88e-01 | 6.88e+00
-5.10e+02 | 3.88e-01 | 6.88e+00
-5.09e+02 | 3.88e-01 | 6.88e+00
-5.09e+02 | 3.88e-01 | 6.88e+00
-5.09e+02 | 3.88e-01 | 6.88e+00
-5.09e+02 | 3.88e-01 | 6.88e+00
-5.09e+02 | 3.84e-01 | 6.88e+00
-5.08e+02 | 3.88e-01 | 6.88e+00
-5.08e+02 | 3.84e-01 | 6.88e+00
-5.08e+02 | 3.88e-01 | 6.88e+00
-5.08e+02 | 3.88e-01 | 6.88e+00
-5.08e+02 | 3.88e-01 | 6.88e+00
-5.07e+02 | 3.84e-01 | 6.88e+00
-5.07e+02 | 3.88e-01 | 6.88e+00
-5.07e+02 | 3.88e-01 | 6.88e+00
-5.07e+02 | 3.88e-01 | 6.88e+00
-5.07e+02 | 3.84e-01 | 6.88e+00
-5.06e+02 | 3.88e-01 | 6.88e+00
-5.06e+02 | 3.88e-01 | 6.88e+00
-5.06e+02 | 3.88e-01 | 6.88e+00
-5.06e+02 | 3.84e-01 | 6.88e+00
-5.06e+02 | 3.84e-01 | 6.88e+00
-5.05e+02 | 3.88e-01 | 6.88e+00
-5.05e+02 | 3.88e-01 | 6.88e+00
-5.05e+02 | 3.88e-01 | 6.88e+00
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
