Frost33/Control-ON-OFF-para-horno-con-temperatura-maxima-70-C-/(commit log)

2018-03-22 Se selecciona los circuitos de disparo y se monta el disparador de smith
    [Disparador.pdsprj, DisparadorEtapadePotencia.pdsprj, Restador.pdsprj]
2018-03-24 Disparador de Smith Totalmente Funcional
    [DisparadorEtapadePotencia.pdsprj]
2018-03-24 Etapa sin realimentacion funcional
    [DisparadorEtapadePotencia.pdsprj, SistemaON-OFF.pdsprj]
2018-03-24 Falta circuito RC
    [DisparadorEtapadePotencia.pdsprj, SistemaON-OFF.pdsprj]
2018-03-28 Graficas de caracterizacion terminadas
    [EscalonV10a11.csv, EscalonV11a12.csv, EscalonV4a5.csv, EscalonV5a6.csv, EscalonV7a12.csv, EscalonV7a8.csv, EscalonV8a9.csv, EscalonV9a10.csv]
2018-03-29 Se terminan graficas y se ajustan simulaciones
    [Disparador.pdsprj, EscalonV7a12.csv, SistemaON-OFF.pdsprj]
2018-04-14 Se realizan retoques
    [34.csv, 40.csv, 52.csv, 62.csv, SistemaON-OFF.pdsprj]
2018-04-14 Se añade informe
    [SistemaON-OFF.pdsprj]
